algyan/algyan_5th/CaseInfo/readme.md

[normal_case]: img/Algyan-5th-01_1.png
[servo_case]: img/Algyan-5th-01_and_servo.png

## Algyan 5th Board Case
**1. Normal Case**
* File(STL) : **Algyan-5th-01_1.stl**
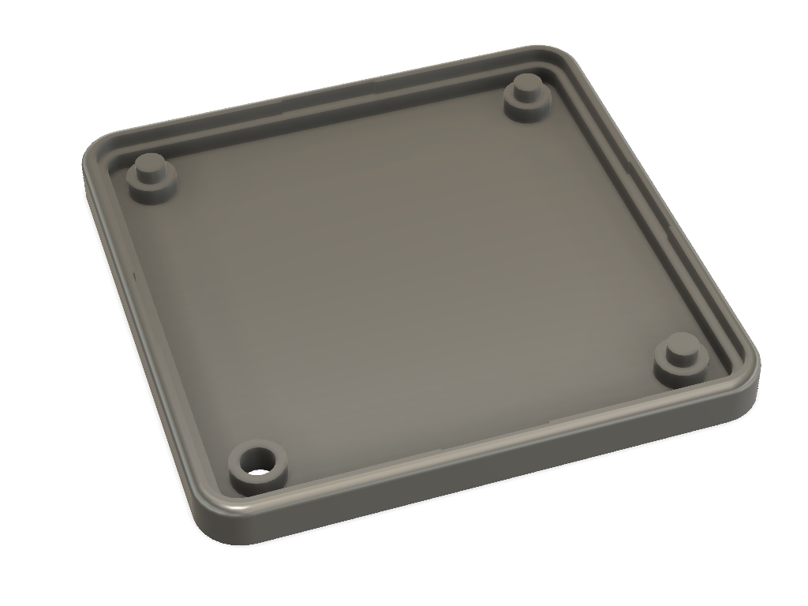
[picture p1: CaseInfo/img/Algyan-5th-01_1.png]
Nomal_Case


**2. With Servo holder Case**
* File(STL) : **Algyan-5th-01_and_servo.stl**
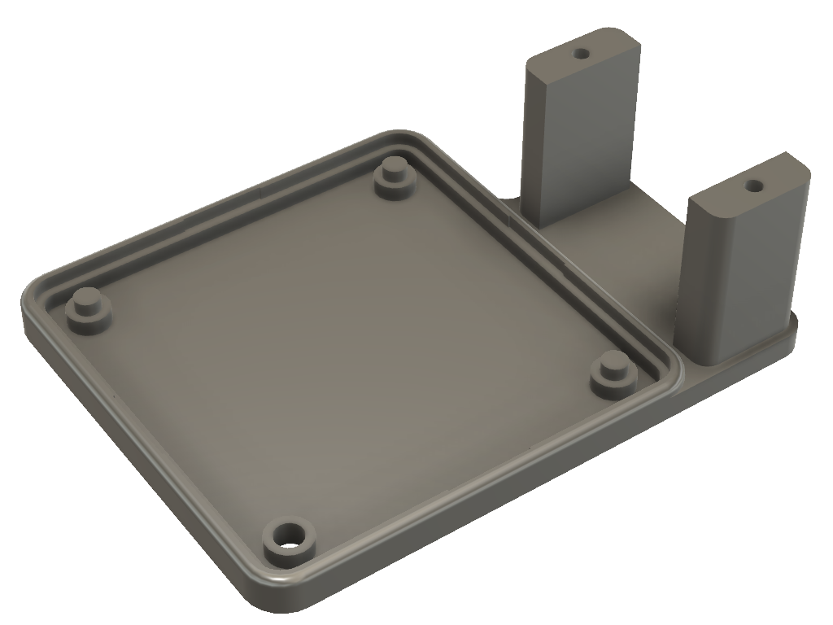
[picture p2: CaseInfo/img/Algyan-5th-01_and_servo.png]
With_Servo_Case
