algyan/algyan_5th/Howto_Soldering/ALGYAN-5th_board_parts_list.pdf

# 【ALGYAN 5th プリント基板 パーツリスト】

CdSセル(1MΩ) GL5528 [ U3 ] 11 | 電子ブザー UGCM1205XP [ SP1 ] 12 極性注意 | 2.54mmピッチピンヘッダ(2ピン) [ CN1 ] 13 | 2.54mmピッチピンヘッダ(3ピン) [ CN3 ] 14 | 2.54mmピッチピンヘッダ(4ピン) [ CN4 ] 15
チップコンデンサー 0.1uF(1608) [ C4、C5 ] 6 | チップコンデンサー 0.01uF(1608) [ C2 ] 7 | チップコンデンサー22uF(3216) [ C1、C3 ] 8 | 低損失表面実装型三端子レギュレー タ NJM2845DL1-33 [ U2 ] 9 | 表面実装用タクトスイッチ TVAF06-A020B-R [ SW1、SW2、SW3 ] 10
チップ抵抗10KΩ(1608) [ R1、R2、R4 ] 1 | チップ抵抗220Ω(1608) [ R3 ] 2 | 表面実装用ショットキーバリアダイ オード RB520S-30 (DB2S40600L) [ D1 ] 3 極性注意 | 緑チップLED OSG5120641E (3216) [ LED1 ] 4 極性注意 | Wi-Fiモジュール ESP32-WROOM-32D [ U1 ] 5
