algyan/algyan_5th/CaseInfo/Algyan-5th-01_and_servo.stl

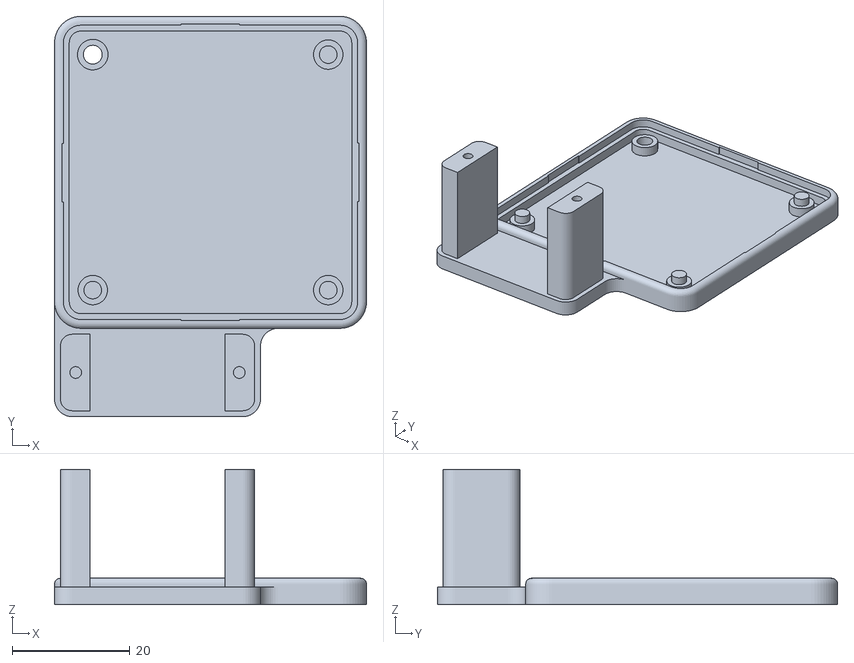
[picture p3: CAD file, 2020-07-14]
CaseInfo/Algyan-5th-01_and_servo.stl
53.0 x 68.0 x 23.0
