algyan/algyan_5th/CaseInfo/Algyan-5th-01_1.stl

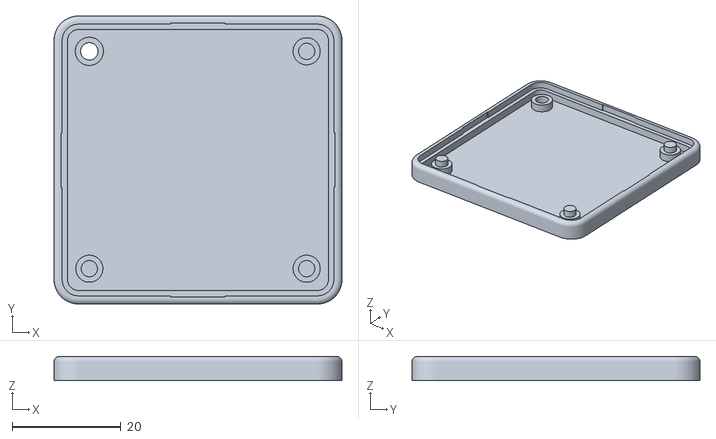
[picture p4: CAD file, 2020-07-14]
CaseInfo/Algyan-5th-01_1.stl
53.0 x 53.0 x 4.50
