algyan/algyan_5th/(threads)

Thread 1 (2020-07-25):

プリント基板パーツリストに「極性の注記」と「取付順番」の追加

tatsu1225, 2020-07-25:
2020/7/25のもくもく会イベントに参加して，参加者の方からのご意見や私自身やってみて，この情報があると良いな．と思った以下の2点を追加したPDFを作成してみました．
良かったら使ってください．(プルリクの方が良いのかも？と思いつつも，PDFファイルに対するプルリクの仕方がすぐに分からなかったのでissueでゴメンナサイ

- 取付向きを間違えそうな電子部品には「極性注意」の記述
- 取付順番を１～１５で振りました

[ALGYAN-5th_board_parts_list_v2.pdf](https://github.com/algyan/algyan_5th/files/4975171/ALGYAN-5th_board_parts_list_v2.pdf)

y-ohe, 2020-07-26:
採用させて頂きました。

tatsu1225, 2020-07-26:
ありがとうございます :-)

Closed 2020-07-26.

Thread 2 (2020-07-26):

1-2 ショットキーバリアダイオード(D1)の説明について

keni-n, 2020-07-26:
Howto_Solderingの1-2 ショットキーバリアダイオード(D1)の極性表記が間違っていると思います。
データシートからは、マークのある方がカソードにみえるのですが。
取り付けは、左がマークのある側(カソード)であっていると思いますが。

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

y-ohe, 2020-07-26:
申し訳ありません。確かにご指摘の通りです。
私がアノードとカソードを間違えていました。
ご指摘ありがとうございました。
資料(マニュアル)についても更新し、処置でき次第connpassのメッセージでもミス＆更新の連絡をするようにします。

y-ohe, 2020-07-26:
マニュアル更新しました。

Closed 2020-07-26.
