algyan/algyan_5th/BoardInfo/Algyan-5th-01.pdf

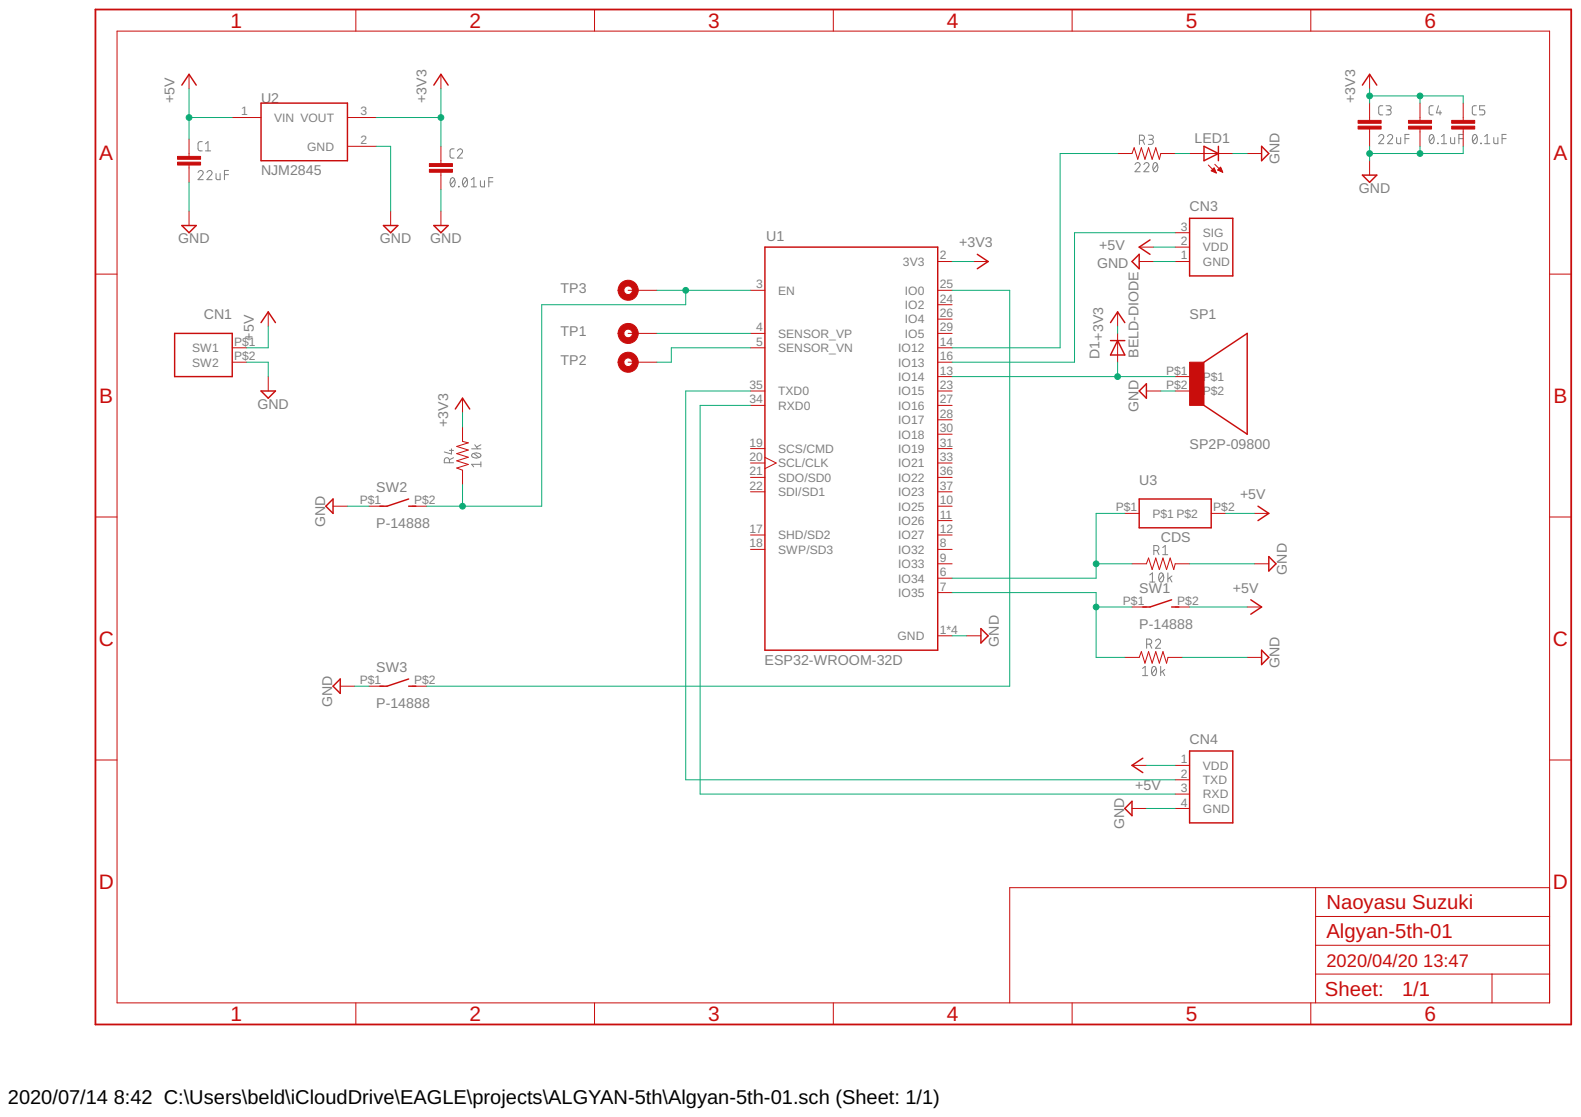
[picture p38: page 1]

2020/07/14 8:42 C:\Users\beld\iCloudDrive\EAGLE\projects\ALGYAN-5th\Algyan-5th-01.sch (Sheet: 1/1)
