algyan/algyan_5th/BoardInfo/Algyan-5th-01.brd

## EAGLE design BoardInfo/Algyan-5th-01.brd (2020-07-13)

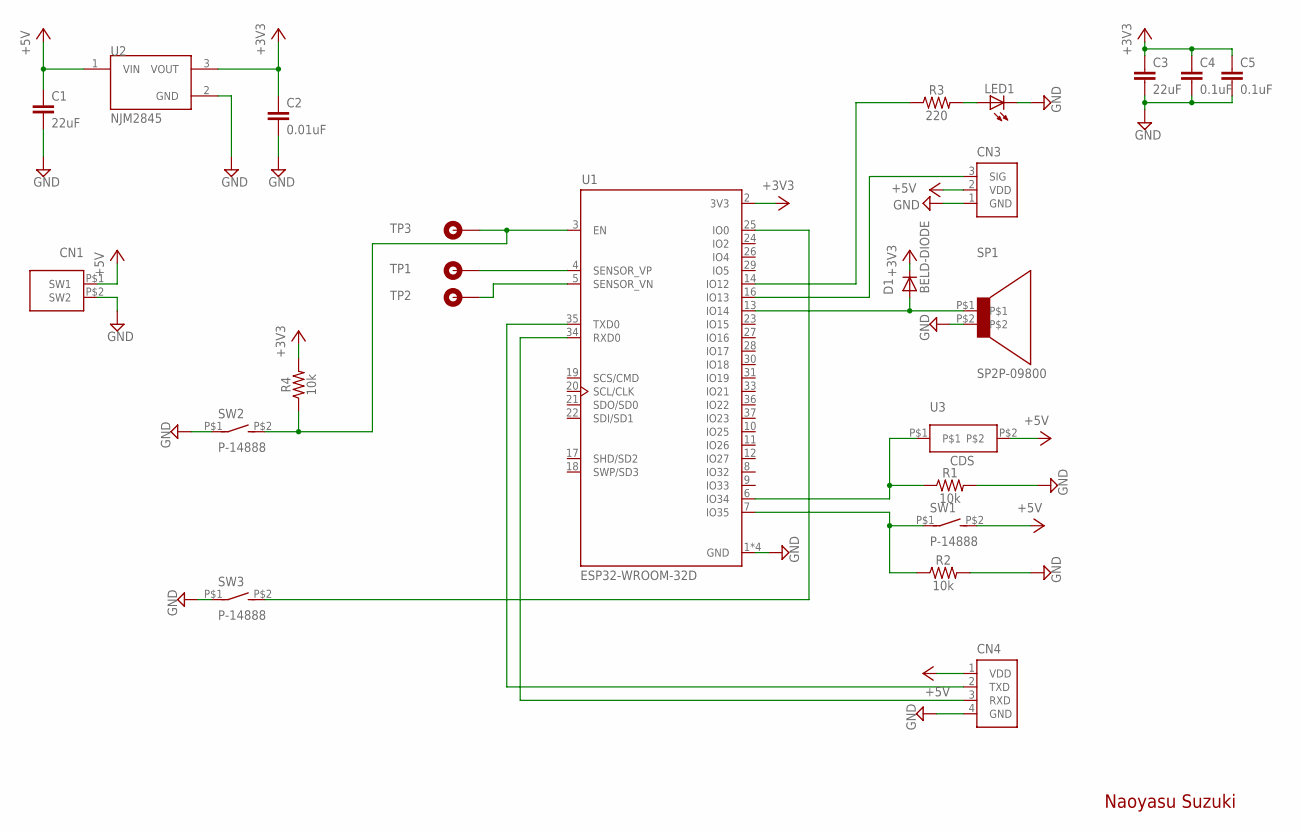
[picture p39: schematic Algyan-5th-01.sch]

Parts:
C1, C3: 22uF; 1210
C2: 0.01uF; 0603
C4, C5: 0.1uF; 0603
CN1: SW－WP; SP2
CN3: MIL3; ML3
CN4: ESP-UART; ML4
D1: BELD-DIODE; DB2S40600L
LED1: LED3216; 3216
R1, R2, R4: 10k; 0603
R3: 220; 0603
SP1: SP2P-09800; P-09800
SW1, SW2, SW3: P-14888
TP1, TP2, TP3: TPHOLE; TP-HOLE
U1: ESP32-WROOM-32D; MODULE_ESP32-WROOM-32D
U2: NJM2845; TO252
U3: CDS

Connections:
+3V3: C2.1, C3.1, C4.1, C5.1, D1.P$1 (K), R4.2, U1.2 (3V3), U2.3 (VOUT)
+5V: C1.1, CN1.P$1 (SW1), CN3.2 (VDD), CN4.1 (VDD), SW1.P$2 (S), U2.1 (VIN), U3.P$2
GND: C1.2, C2.2, C3.2, C4.2, C5.2, CN1.P$2 (SW2), CN3.1 (GND), CN4.4 (GND), LED1.P$1 (C), R1.2, R2.2, SP1.P$2, SW2.P$1, SW3.P$1, U1.1 (GND), U1.15 (GND), U1.38 (GND), U1.39 (GND), U2.2 (GND)
unnamed: R1.1, U1.6 (IO34), U3.P$1
unnamed: CN3.3 (SIG), U1.16 (IO13)
unnamed: R2.1, SW1.P$1, U1.7 (IO35)
unnamed: D1.P$2 (A), SP1.P$1, U1.13 (IO14)
unnamed: R4.1, SW2.P$2 (S), TP3.1, U1.3 (EN)
unnamed: TP1.1, U1.4 (SENSOR_VP)
unnamed: TP2.1, U1.5 (SENSOR_VN)
unnamed: CN4.2 (TXD), U1.35 (TXD0)
unnamed: CN4.3 (RXD), U1.34 (RXD0)
unnamed: R3.1, U1.14 (IO12)
unnamed: LED1.P$2 (A), R3.2
unnamed: SW3.P$2 (S), U1.25 (IO0)

Notes on the sheet:
Naoyasu Suzuki

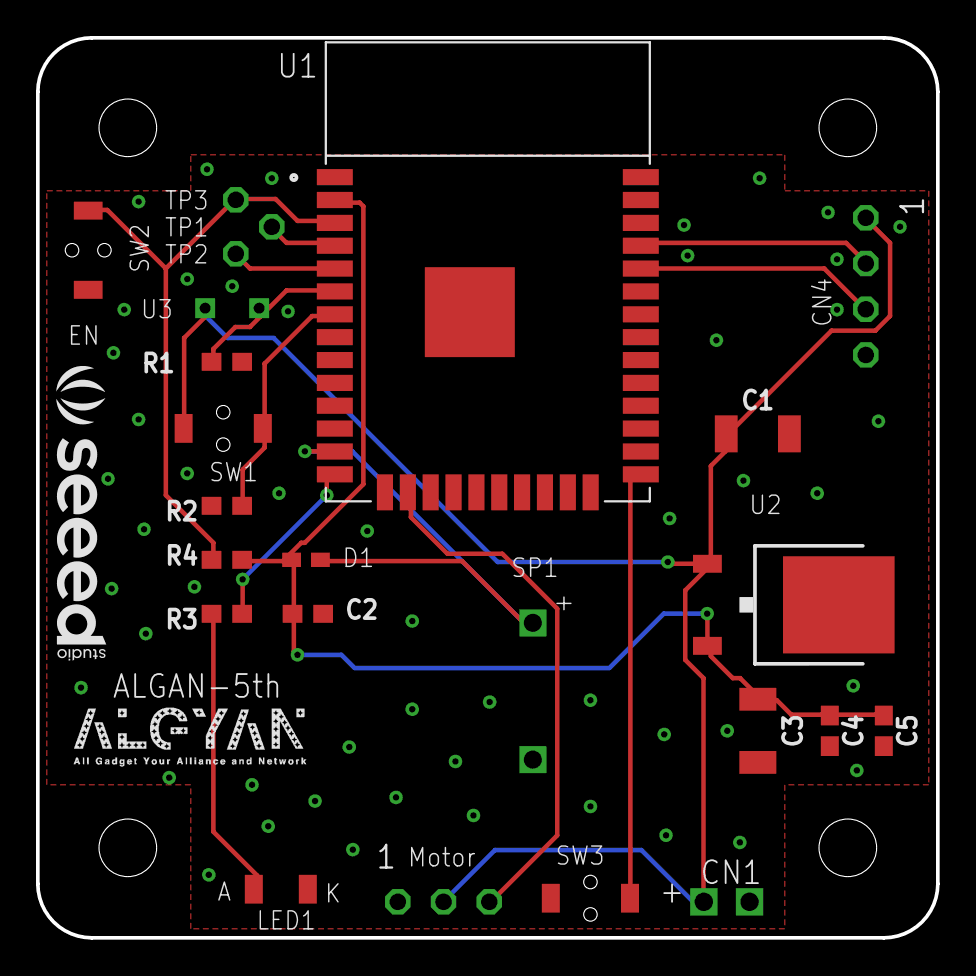
[picture p40: board Algyan-5th-01.brd from above]

Board: 2 copper layers, 50.0 x 50.0 mm, 24 parts (0 on the bottom side), 15 nets.
