algyan/algyan_5th/(commit log)

2020-07-09 ハードウェアチェック用ソフト、新規コミット
2020-07-09 markup 文法が間違っていてみにくかったため修正
2020-07-13 Create BoardInfo.txt
    1.Create
2020-07-14 Add Case 3D model files
    [Algyan-5th-01_1.stl, Algyan-5th-01_and_servo.stl]
2020-07-23 説明文を大幅に修正
2020-07-23 誤記修正。
2020-07-23 誤記修正
2020-07-24 はんだ付けの事前準備を登録
2020-07-24 JPGファイルリンクを修正
2020-07-24 テスト用Appへのリンクを修正
2020-07-24 パーツリストのPDFへのリンク追加
2020-07-25 はんだ付けマニュアルを更新
2020-07-26 ショットキーバリアダイオードのアノード/カソードの説明誤記訂正
2020-07-26 パーツリストにはんだ付け順序と極性のある部品に「極性注意」を追記
2020-08-02 CdS and SW change connect 5V -> 3.3V
